devbisme/CAT-Board/(notices)

Notices in the files:
pcb/FPGA_CFG.sch:
(c) 2015 - 2016
CC BY 4.0
pcb/CAT.kicad_pcb:
(c) 2015
